ElonaKhoshaba/rx_tapeout/Group4_PCB_AP.kicad_pcb

## KiCad design Group4_PCB_AP.kicad_pcb (2025-09-10)

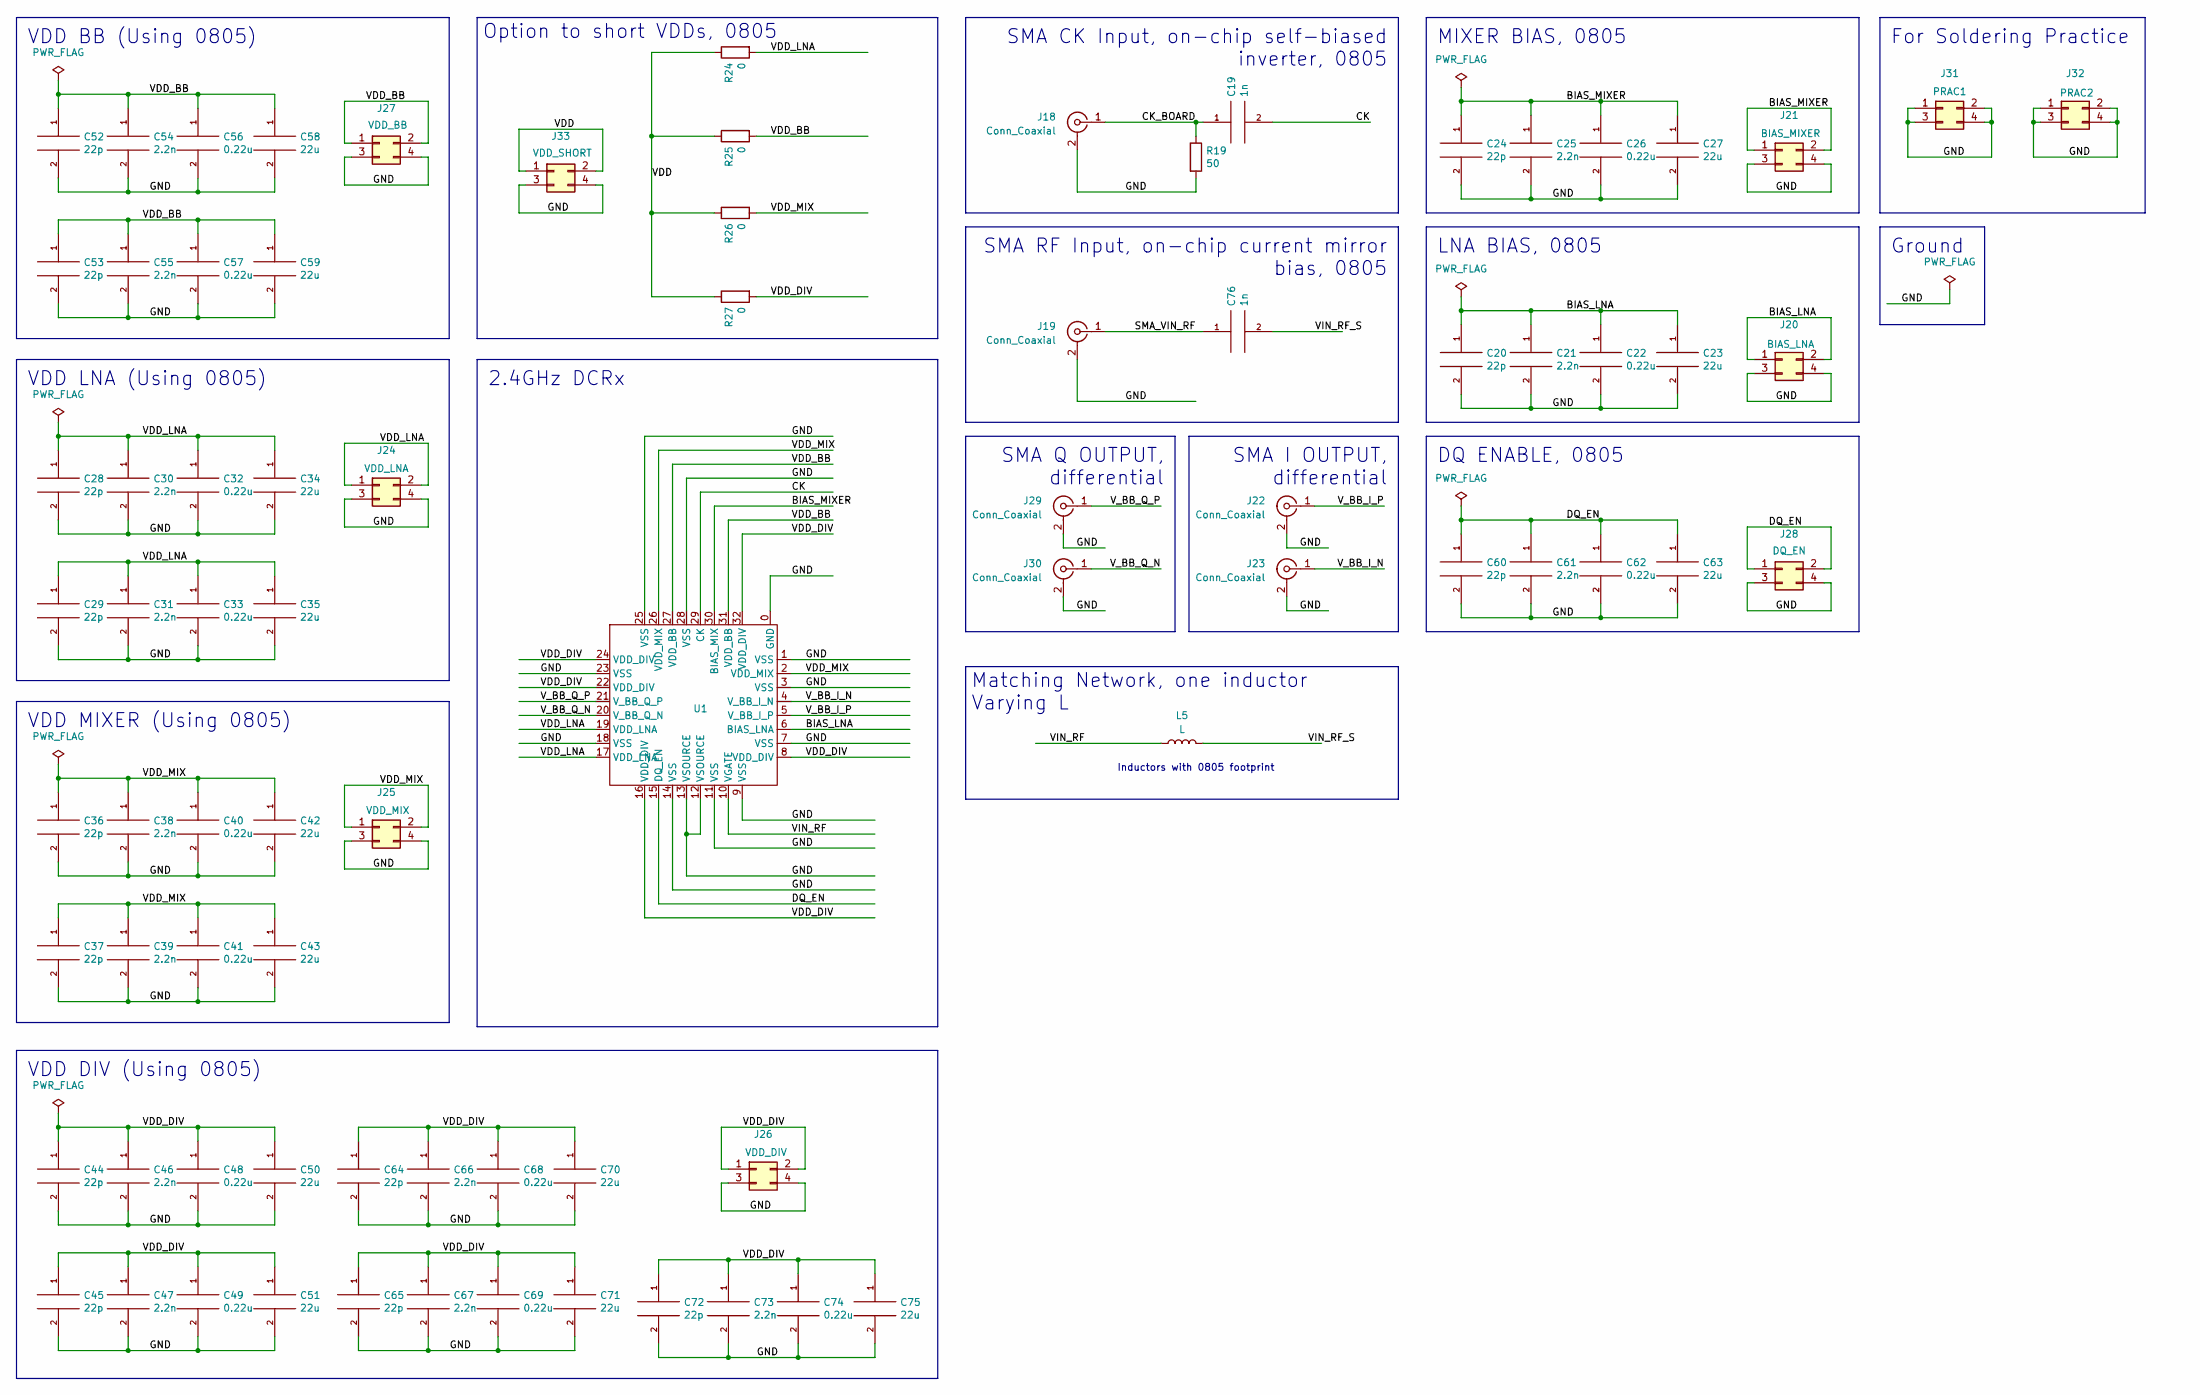
[picture p1: schematic Group4_PCB_AP.kicad_sch]

Parts:
C19, C76: 1n; C_0805_2012Metric_Pad1.18x1.45mm_HandSolder; LCSC Part # C46653
C20, C24, C28, C29, C36, C37, C44, C45, C52, C53, C60, C64, C65, C72: 22p; C_0805_2012Metric_Pad1.18x1.45mm_HandSolder; LCSC Part # C1804
C21, C25, C30, C31, C38, C39, C46, C47, C54, C55, C61, C66, C67, C73: 2.2n; C_0805_2012Metric_Pad1.18x1.45mm_HandSolder; LCSC Part # C28260
C22, C26, C32, C33, C40, C41, C48, C49, C56, C57, C62, C68, C69, C74: 0.22u; C_0805_2012Metric_Pad1.18x1.45mm_HandSolder; LCSC Part # C5378
C23, C27, C34, C35, C42, C43, C50, C51, C58, C59, C63, C70, C71, C75: 22u; C_0805_2012Metric_Pad1.18x1.45mm_HandSolder; LCSC Part # C45783
J18, J19, J22, J23, J29, J30: Conn_Coaxial; SMA_Samtec_SMA-J-P-H-ST-EM1_EdgeMount
J20, J21, J24, J25, J26, J27, J28, J31, J32, J33: Conn_02x02_Odd_Even; PinHeader_2x02_P2.54mm_Vertical
L5: L; L_0805_2012Metric_Pad1.15x1.40mm_HandSolder
R19: 50; R_0805_2012Metric_Pad1.20x1.40mm_HandSolder
R24, R25, R26, R27: 0; R_0805_2012Metric_Pad1.20x1.40mm_HandSolder; LCSC Part # C17738
U1: CCJ04403

Connections:
/BIAS_LNA: C20.1, C21.1, C22.1, C23.1, J20.1, J20.2, U1.6 (BIAS_LNA)
/BIAS_MIXER: C24.1, C25.1, C26.1, C27.1, J21.1, J21.2, U1.30 (BIAS_MIX)
/CK: C19.2, U1.29 (CK)
/CK_BOARD: C19.1, J18.1 (In), R19.1
/DQ_EN: C60.1, C61.1, C62.1, C63.1, J28.1, J28.2, U1.15 (DQ_EN)
/GND: C20.2, C21.2, C22.2, C23.2, C24.2, C25.2, C26.2, C27.2, C28.2, C29.2, C30.2, C31.2, C32.2, C33.2, C34.2, C35.2, C36.2, C37.2, C38.2, C39.2, C40.2, C41.2, C42.2, C43.2, C44.2, C45.2, C46.2, C47.2, C48.2, C49.2, C50.2, C51.2, C52.2, C53.2, C54.2, C55.2, C56.2, C57.2, C58.2, C59.2, C60.2, C61.2, C62.2, C63.2, C64.2, C65.2, C66.2, C67.2, C68.2, C69.2, C70.2, C71.2, C72.2, C73.2, C74.2, C75.2, J18.2 (Ext), J19.2 (Ext), J20.3, J20.4, J21.3, J21.4, J22.2 (Ext), J23.2 (Ext), J24.3, J24.4, J25.3, J25.4, J26.3, J26.4, J27.3, J27.4, J28.3, J28.4, J29.2 (Ext), J30.2 (Ext), J31.1, J31.2, J31.3, J31.4, J32.1, J32.2, J32.3, J32.4, J33.3, J33.4, R19.2, U1.0 (GND), U1.1 (VSS), U1.3 (VSS), U1.7 (VSS), U1.9 (VSS), U1.11 (VSS), U1.12 (VSOURCE), U1.13 (VSOURCE), U1.14 (VSS), U1.18 (VSS), U1.23 (VSS), U1.25 (VSS), U1.28 (VSS)
/SMA_VIN_RF: C76.1, J19.1 (In)
/VDD: J33.1, J33.2, R24.1, R25.1, R26.1, R27.1
/VDD_BB: C52.1, C53.1, C54.1, C55.1, C56.1, C57.1, C58.1, C59.1, J27.1, J27.2, R25.2, U1.27 (VDD_BB), U1.31 (VDD_BB)
/VDD_DIV: C44.1, C45.1, C46.1, C47.1, C48.1, C49.1, C50.1, C51.1, C64.1, C65.1, C66.1, C67.1, C68.1, C69.1, C70.1, C71.1, C72.1, C73.1, C74.1, C75.1, J26.1, J26.2, R27.2, U1.8 (VDD_DIV), U1.16 (VDD_DIV), U1.22 (VDD_DIV), U1.24 (VDD_DIV), U1.32 (VDD_DIV)
/VDD_LNA: C28.1, C29.1, C30.1, C31.1, C32.1, C33.1, C34.1, C35.1, J24.1, J24.2, R24.2, U1.17 (VDD_LNA), U1.19 (VDD_LNA)
/VDD_MIX: C36.1, C37.1, C38.1, C39.1, C40.1, C41.1, C42.1, C43.1, J25.1, J25.2, R26.2, U1.2 (VDD_MIX), U1.26 (VDD_MIX)
/VIN_RF: L5.2, U1.10 (VGATE)
/VIN_RF_S: C76.2, L5.1
/V_BB_I_N: J23.1 (In), U1.4 (V_BB_I_N)
/V_BB_I_P: J22.1 (In), U1.5 (V_BB_I_P)
/V_BB_Q_N: J30.1 (In), U1.20 (V_BB_Q_N)
/V_BB_Q_P: J29.1 (In), U1.21 (V_BB_Q_P)

Notes on the sheet:
Inductors with 0805 footprint
DQ ENABLE, 0805
VDD DIV (Using 0805)
SMA CK Input, on-chip self-biased inverter, 0805
Ground
2.4GHz DCRx
VDD BB (Using 0805)
VDD MIXER (Using 0805)
SMA I OUTPUT, differential
LNA BIAS, 0805
SMA Q OUTPUT, differential
Option to short VDDs, 0805
VDD LNA (Using 0805)
SMA RF Input, on-chip current mirror bias, 0805
Matching Network, one inductor Varying L
MIXER BIAS, 0805
For Soldering Practice

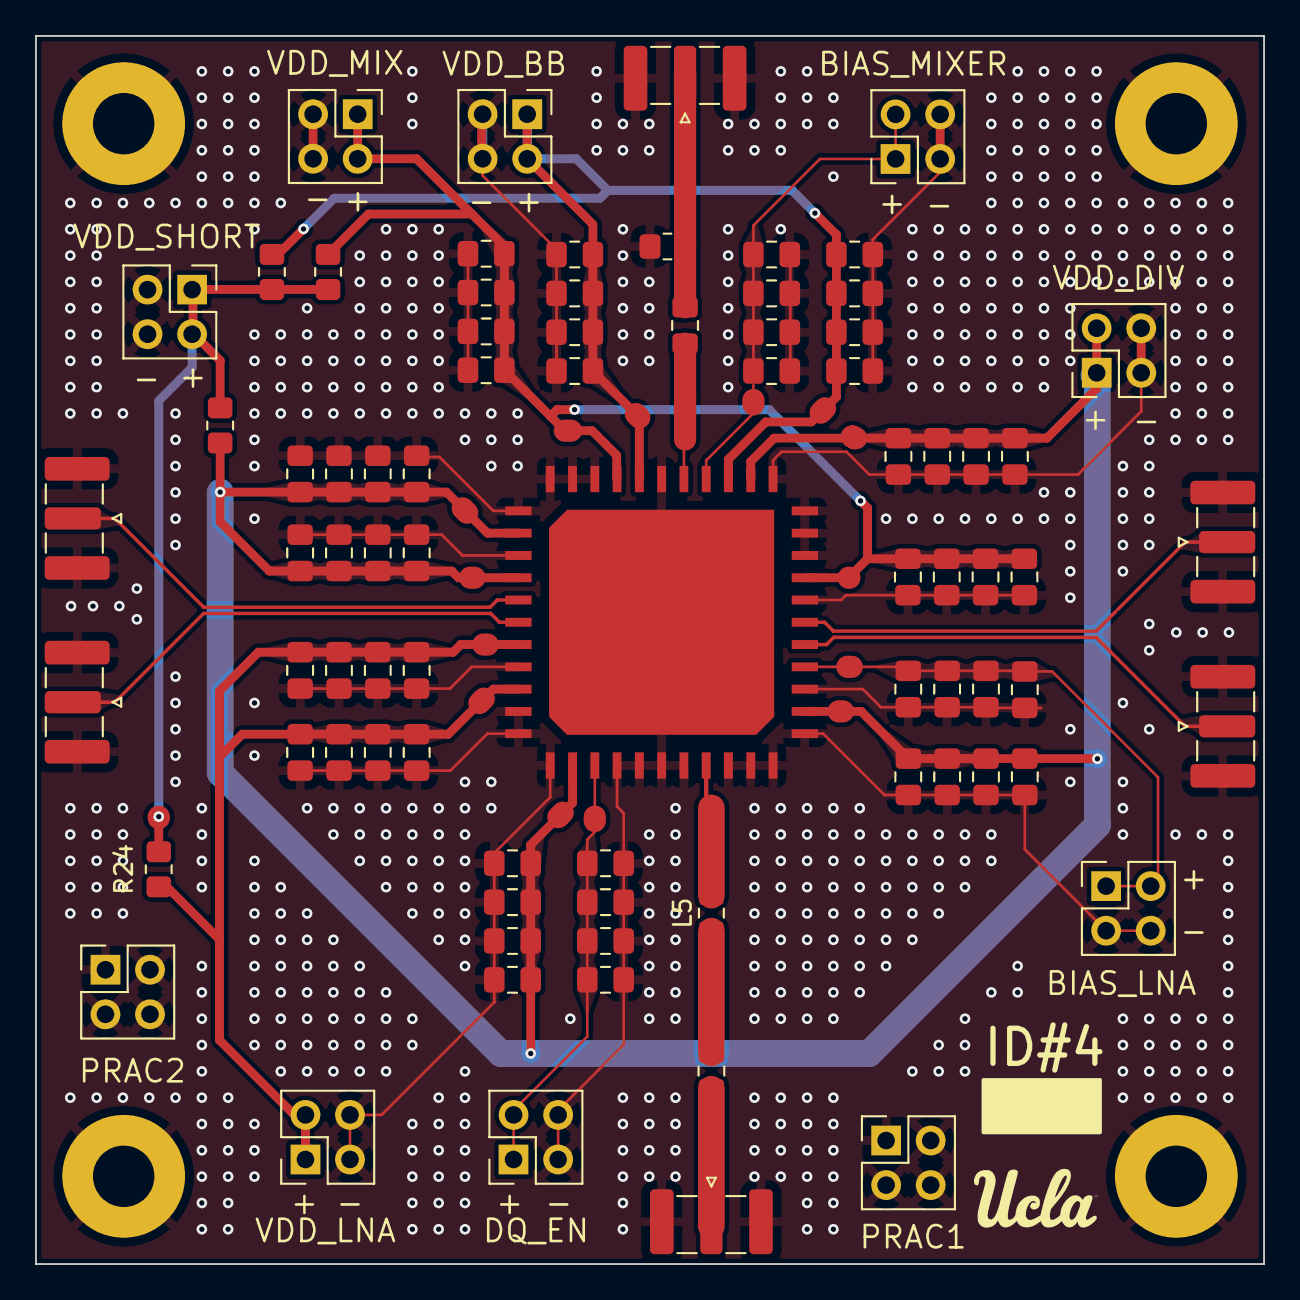
[picture p2: board Group4_PCB_AP.kicad_pcb from above]

Board: 2 copper layers, 70.0 x 70.0 mm, 81 parts (0 on the bottom side), 18 nets.
