ElonaKhoshaba/rx_tapeout/(commit log)

2025-08-17 Creating PCB copy in layout
    Created PCB layout and tied all the components to the respective components in schematic view.
    [Group4_PCB_AP.kicad_pcb, Group4_PCB_AP.kicad_sch]
2025-08-24 Reorganized layout
    Reorganized layout and updated nets and chip symbol to reflect proper pinout
    [Group4_PCB_AP.kicad_pcb, Group4_PCB_AP.kicad_sch]
2025-08-25 Started routing
    Routed almost all nets. Need to finish routing VDD_DIV, GND pour, and matching network
    [Group4_PCB_AP.kicad_pcb]
2025-08-27 Finished Routing
    At 1:35 in video. Finished routing everything. Need to add probe points, via stitching, ID marker, matching network
    [Group4_PCB_AP.kicad_pcb, Group4_PCB_AP.kicad_sch]
2025-08-28 Additions to schematic and layout
    Added coupling cap for RF input
    Added matching network with zero ohm resistors to detach it
    Added zero ohm resistors to VDD lines.
    Need to add probe points, via stitches, and ID
    [Group4_PCB_AP.kicad_pcb, Group4_PCB_AP.kicad_sch]
2025-08-28 updated matching nw, added probe points, via stitching. TODO: fix DRC errors
    [Group4_PCB_AP.kicad_pcb, Group4_PCB_AP.kicad_sch]
2025-08-28 Added probe point to bias_mixer
    As title says
    [Group4_PCB_AP.kicad_pcb]
2025-08-29 Cleaned up matching network
    Cleaned up schematic and layout for matching network, removed termination and 0 ohm resistors, removed probe points on all RF traces. Removed zero ohm from VSOURCE
    [Group4_PCB_AP.kicad_pcb, Group4_PCB_AP.kicad_sch]
2025-09-01 fixed up some caps, 4mm away from chip. need to check if the adjcaent caps r too close
    [Group4_PCB_AP.kicad_pcb]
2025-09-07 finished rerouting
    [Group4_PCB_AP.kicad_pcb]
2025-09-07 fixed DRC except ONE; added via stitching; need to do test points
    [Group4_PCB_AP.kicad_pcb]
2025-09-08 Fixed final DRC error
    DRC clean and added probe points
    [Group4_PCB_AP.kicad_pcb]
2025-09-10 Added UCLA Silk Screen and Gerber files
    Finalized PCB and made Gerber files
    [Group4_PCB_AP-B_Cu.gbr, Group4_PCB_AP-B_Mask.gbr, Group4_PCB_AP-B_Paste.gbr, Group4_PCB_AP-B_Silkscreen.gbr, Group4_PCB_AP-Edge_Cuts.gbr, Group4_PCB_AP-F_Cu.gbr, Group4_PCB_AP-F_Mask.gbr, Group4_PCB_AP-F_Paste.gbr]
